aishani-sood21/Embedded_Systems/Demos/tec-characterisation-setup-1.jpeg

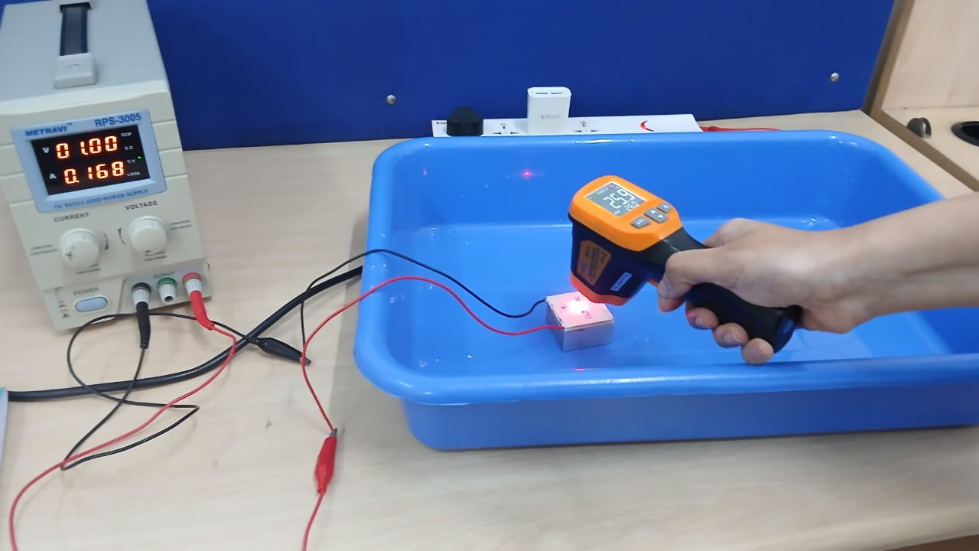
Demos/tec-characterisation-setup-1.jpeg
