aishani-sood21/Embedded_Systems/Demos/tec-characterisation-setup-2.jpeg

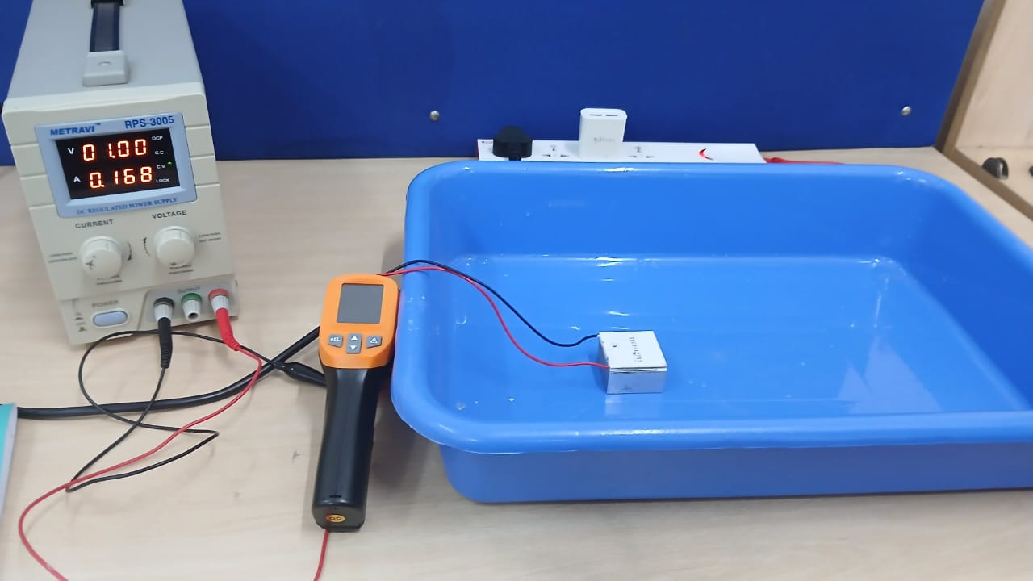
Demos/tec-characterisation-setup-2.jpeg
