aishani-sood21/Embedded_Systems/Code/README.md

# Code Structure
Added the code for the dashboard to be used
Added the code for TEC-PID code implementation.
Added the code for the optical monitoring system
