aishani-sood21/Embedded_Systems/Demos/2.jpeg

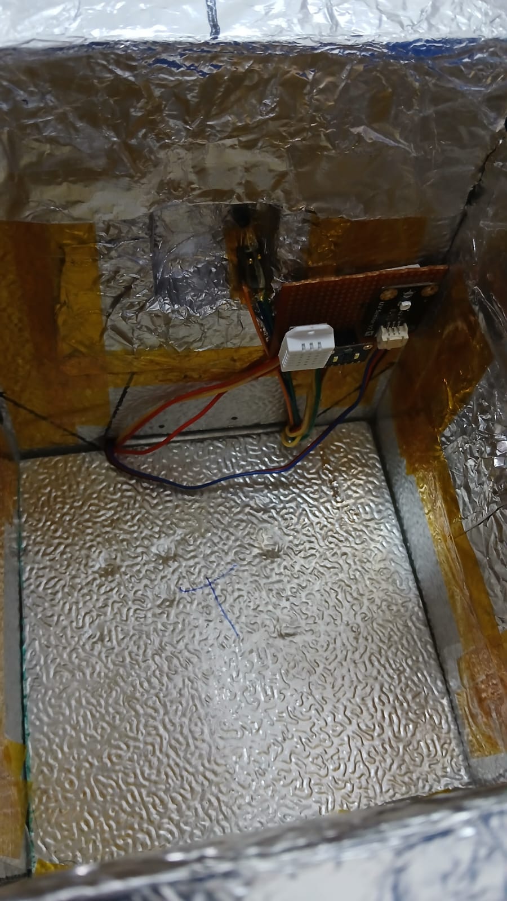
Demos/2.jpeg
