aishani-sood21/Embedded_Systems/Demos/3.jpeg

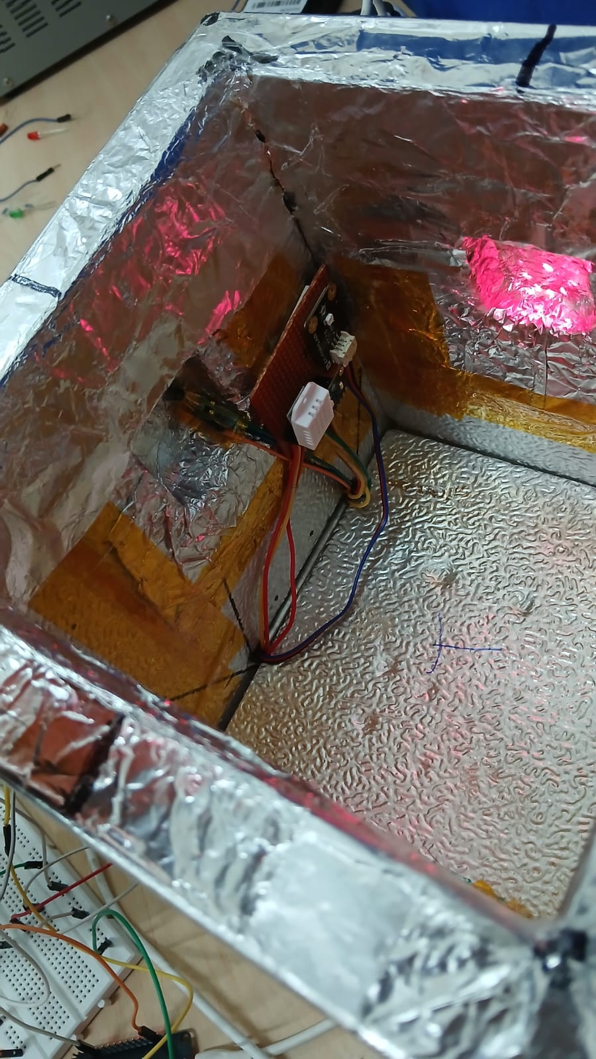
Demos/3.jpeg
