aishani-sood21/Embedded_Systems/Demos/4.jpeg

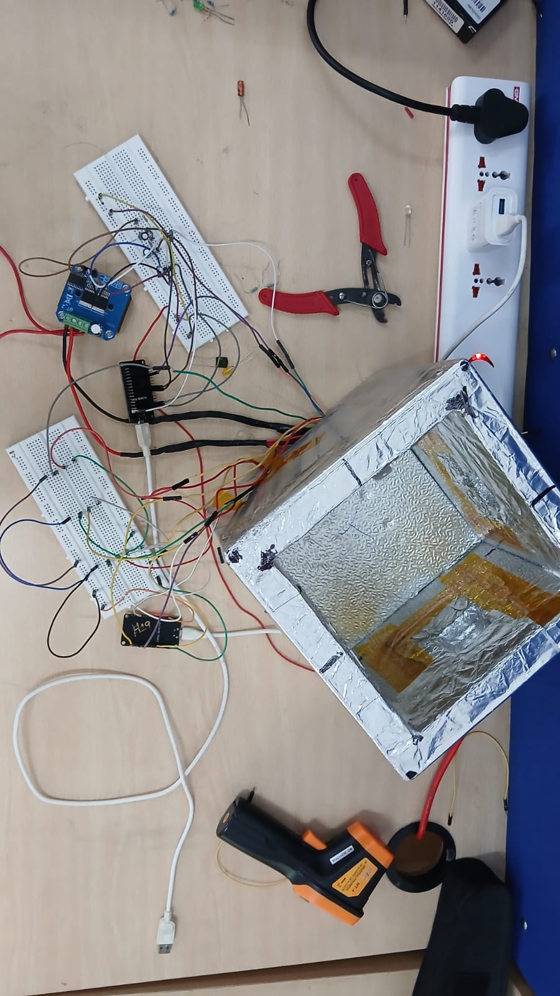
Demos/4.jpeg
