aishani-sood21/Embedded_Systems/Demos/faraday-cage-diagonal.jpeg

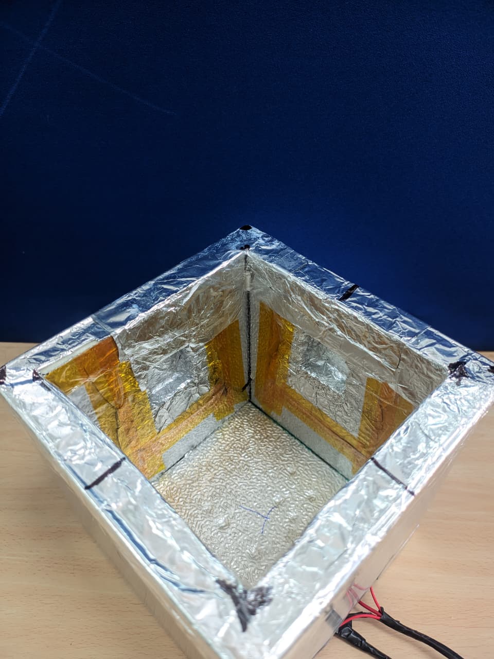
Demos/faraday-cage-diagonal.jpeg
