aishani-sood21/Embedded_Systems/Demos/faraday-cage-side-view.jpeg

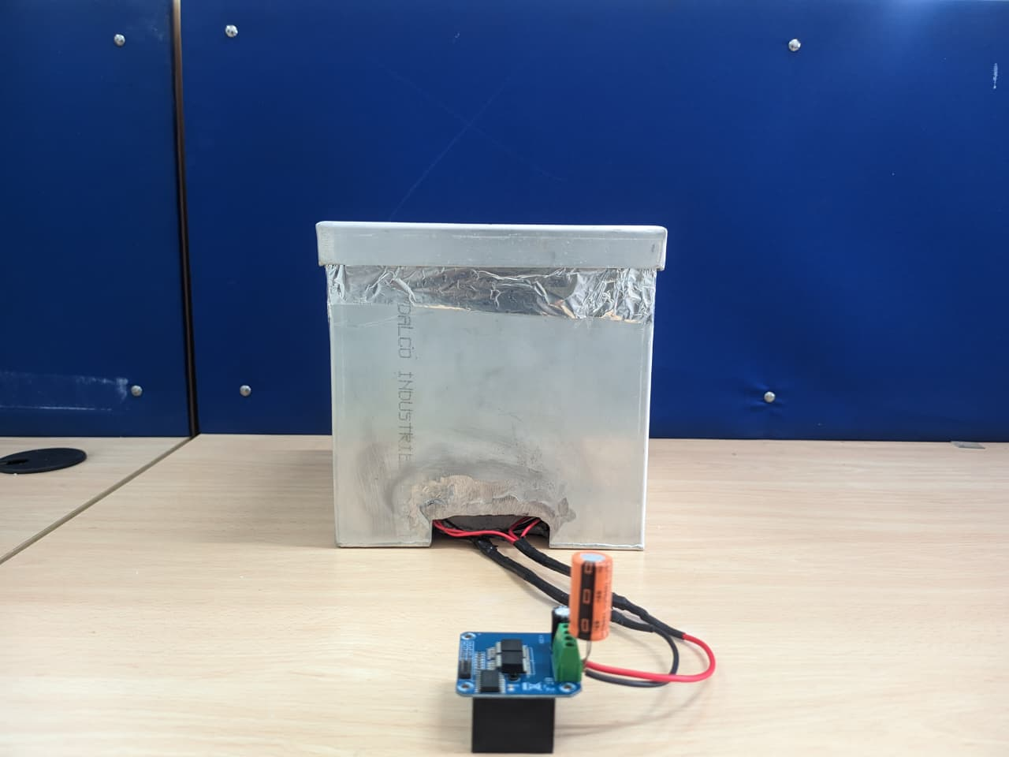
Demos/faraday-cage-side-view.jpeg
